kit-adl/astropix/3D/AstroPix1/deckel.PNG

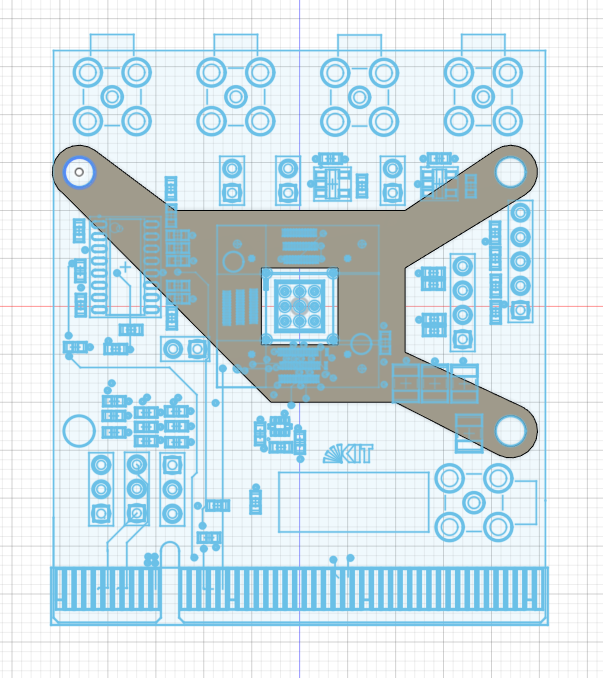
3D/AstroPix1/deckel.PNG
