kit-adl/astropix/README.md

# Astropix Repository

See PCB Folder for Altium designer project, and Astropix_v1_202004 for Astropix 1 Software and Nexys Video Firmware
