kit-adl/astropix/PCB/AstroPix4/pdf/4L_1.55mm_end_Cu 35 outer, 35 inner.pdf

A00 B00

50200238 | 18 | VS | 1
50200642 | 288 | | 2
50200643 | 0 | | 3

710

| 35 | L2
50200660 | | | 4
| 35 | L3
50200643 | 288 | | 5
50200642 | 0 | | 6
50200238 | 18 | RS | 7
Artikel: | 470 | ML4

Kunde:

Erstellt: | Kracht, Enrico
Datum: | 17.04.2015

Prozesstechnik: B: Undefiniert
Materialtext | Mat. Nr. | µm | Aufbau | Prozessaufbau
B00: | 1440 µm | Tol+: | 155 µm | Tol-: | 155 µm | Dmax: | 1595 µm | Dmin: | 1285 µm
0 µm | Tol+: | 0 µm | Tol-: | 0 µm | Dmax: | 0 µm | Dmin: | 0 µm
Dicke (D): | 1550 µm | Tol+: | 155 µm | Tol-: | 155 µm | Dmax: | 1705 µm | Dmin: | 1395 µm
Messstelle: (05) über LM und galv.Cu; beidseitig | nominal: | 1392 µm
