kit-adl/astropix/3D/AstroPix1/Deckel.stl

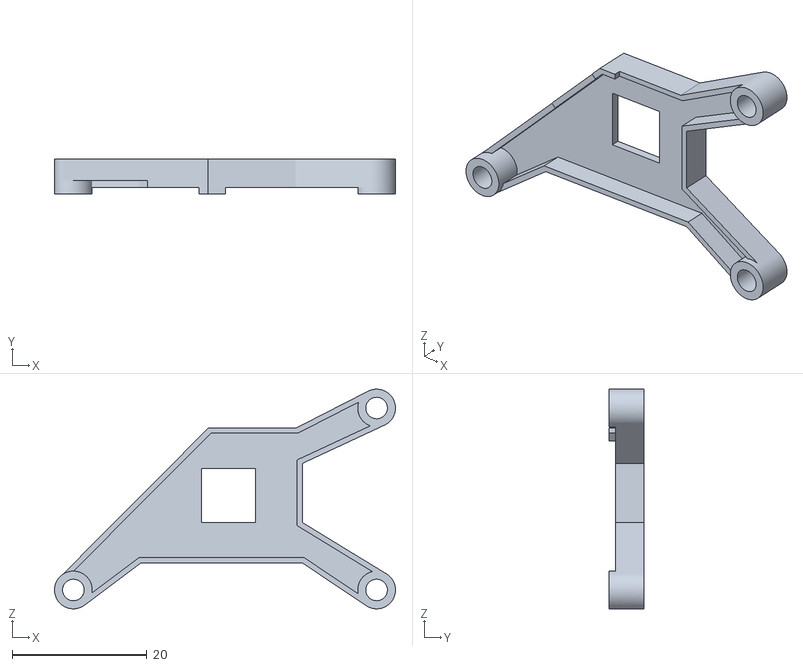
[picture p2: CAD file, 2021-02-23]
3D/AstroPix1/Deckel.stl
50.6 x 5.20 x 32.6
