kit-adl/astropix/3D/AstroPix2/astropix_v2.stl

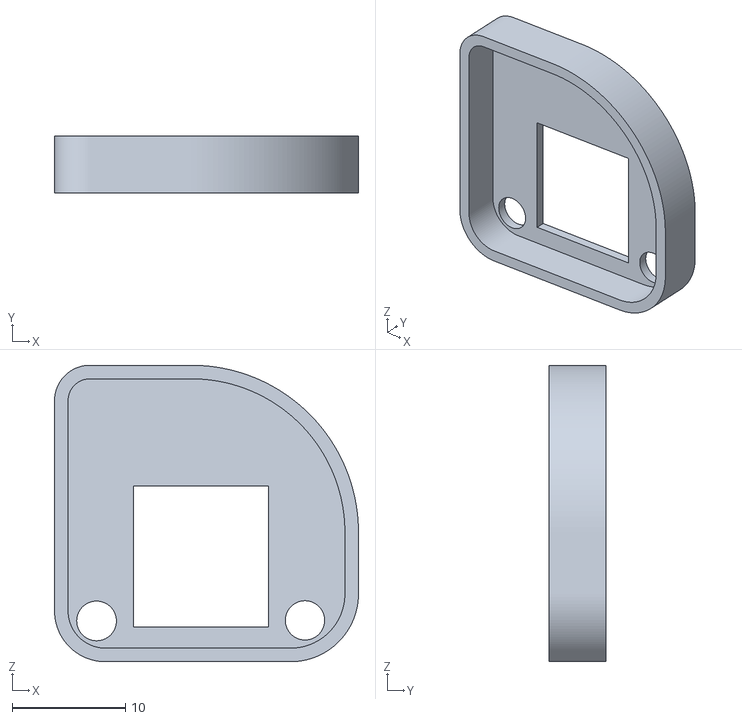
[picture p3: CAD file, 2021-11-17]
3D/AstroPix2/astropix_v2.stl
26.9 x 5.00 x 26.2
