kit-adl/astropix/PCB/AstroPix1/User Library-1x3 TH Pitch 2_54mm.SLDPRT

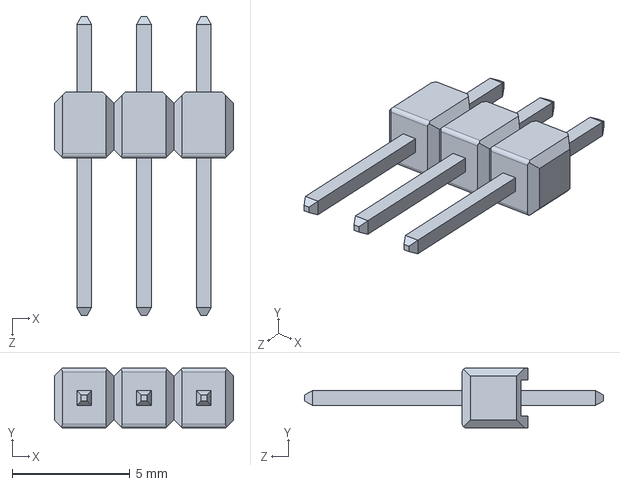
[picture p4: CAD file, 2020-10-21]
PCB/AstroPix1/User Library-1x3 TH Pitch 2_54mm.SLDPRT
7.62 x 2.54 x 12.7 mm
