kit-adl/astropix/PCB/AstroPix1/CircuitWorks-JUMPER.SLDPRT

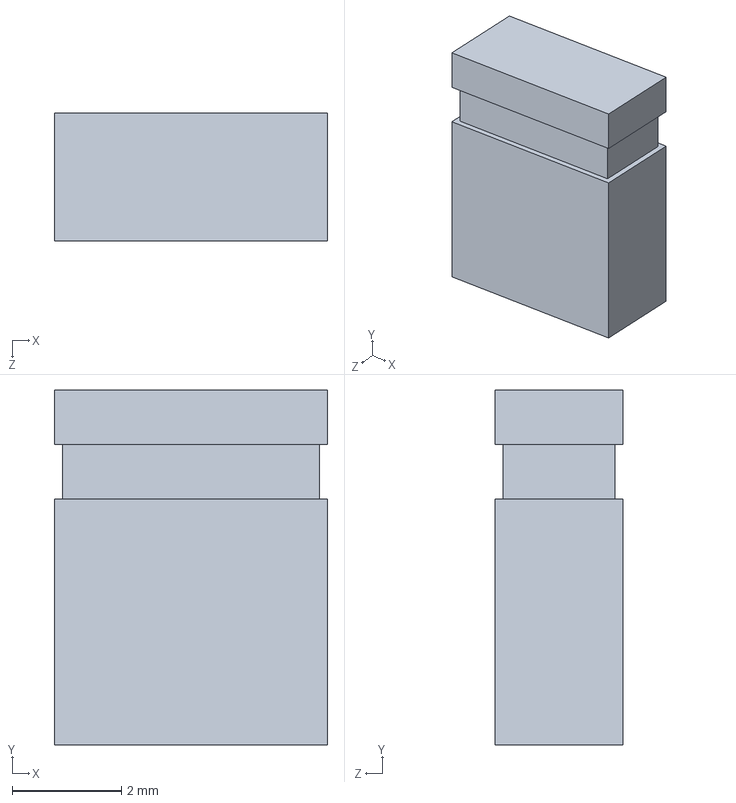
[picture p5: CAD file, 2020-10-21]
PCB/AstroPix1/CircuitWorks-JUMPER.SLDPRT
5.00 x 6.50 x 2.35 mm
