kit-adl/astropix/PCB/AstroPix1/User Library-HDR1X1 Rectangular Straight.SLDPRT

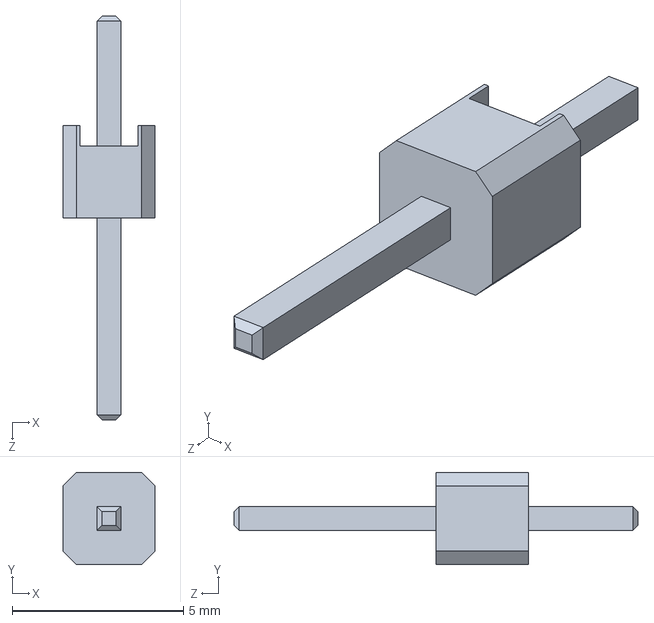
[picture p6: CAD file, 2020-10-21]
PCB/AstroPix1/User Library-HDR1X1 Rectangular Straight.SLDPRT
2.70 x 2.70 x 11.8 mm
