kit-adl/astropix/PCB/AstroPix1/Astropix_Carrier.pdf

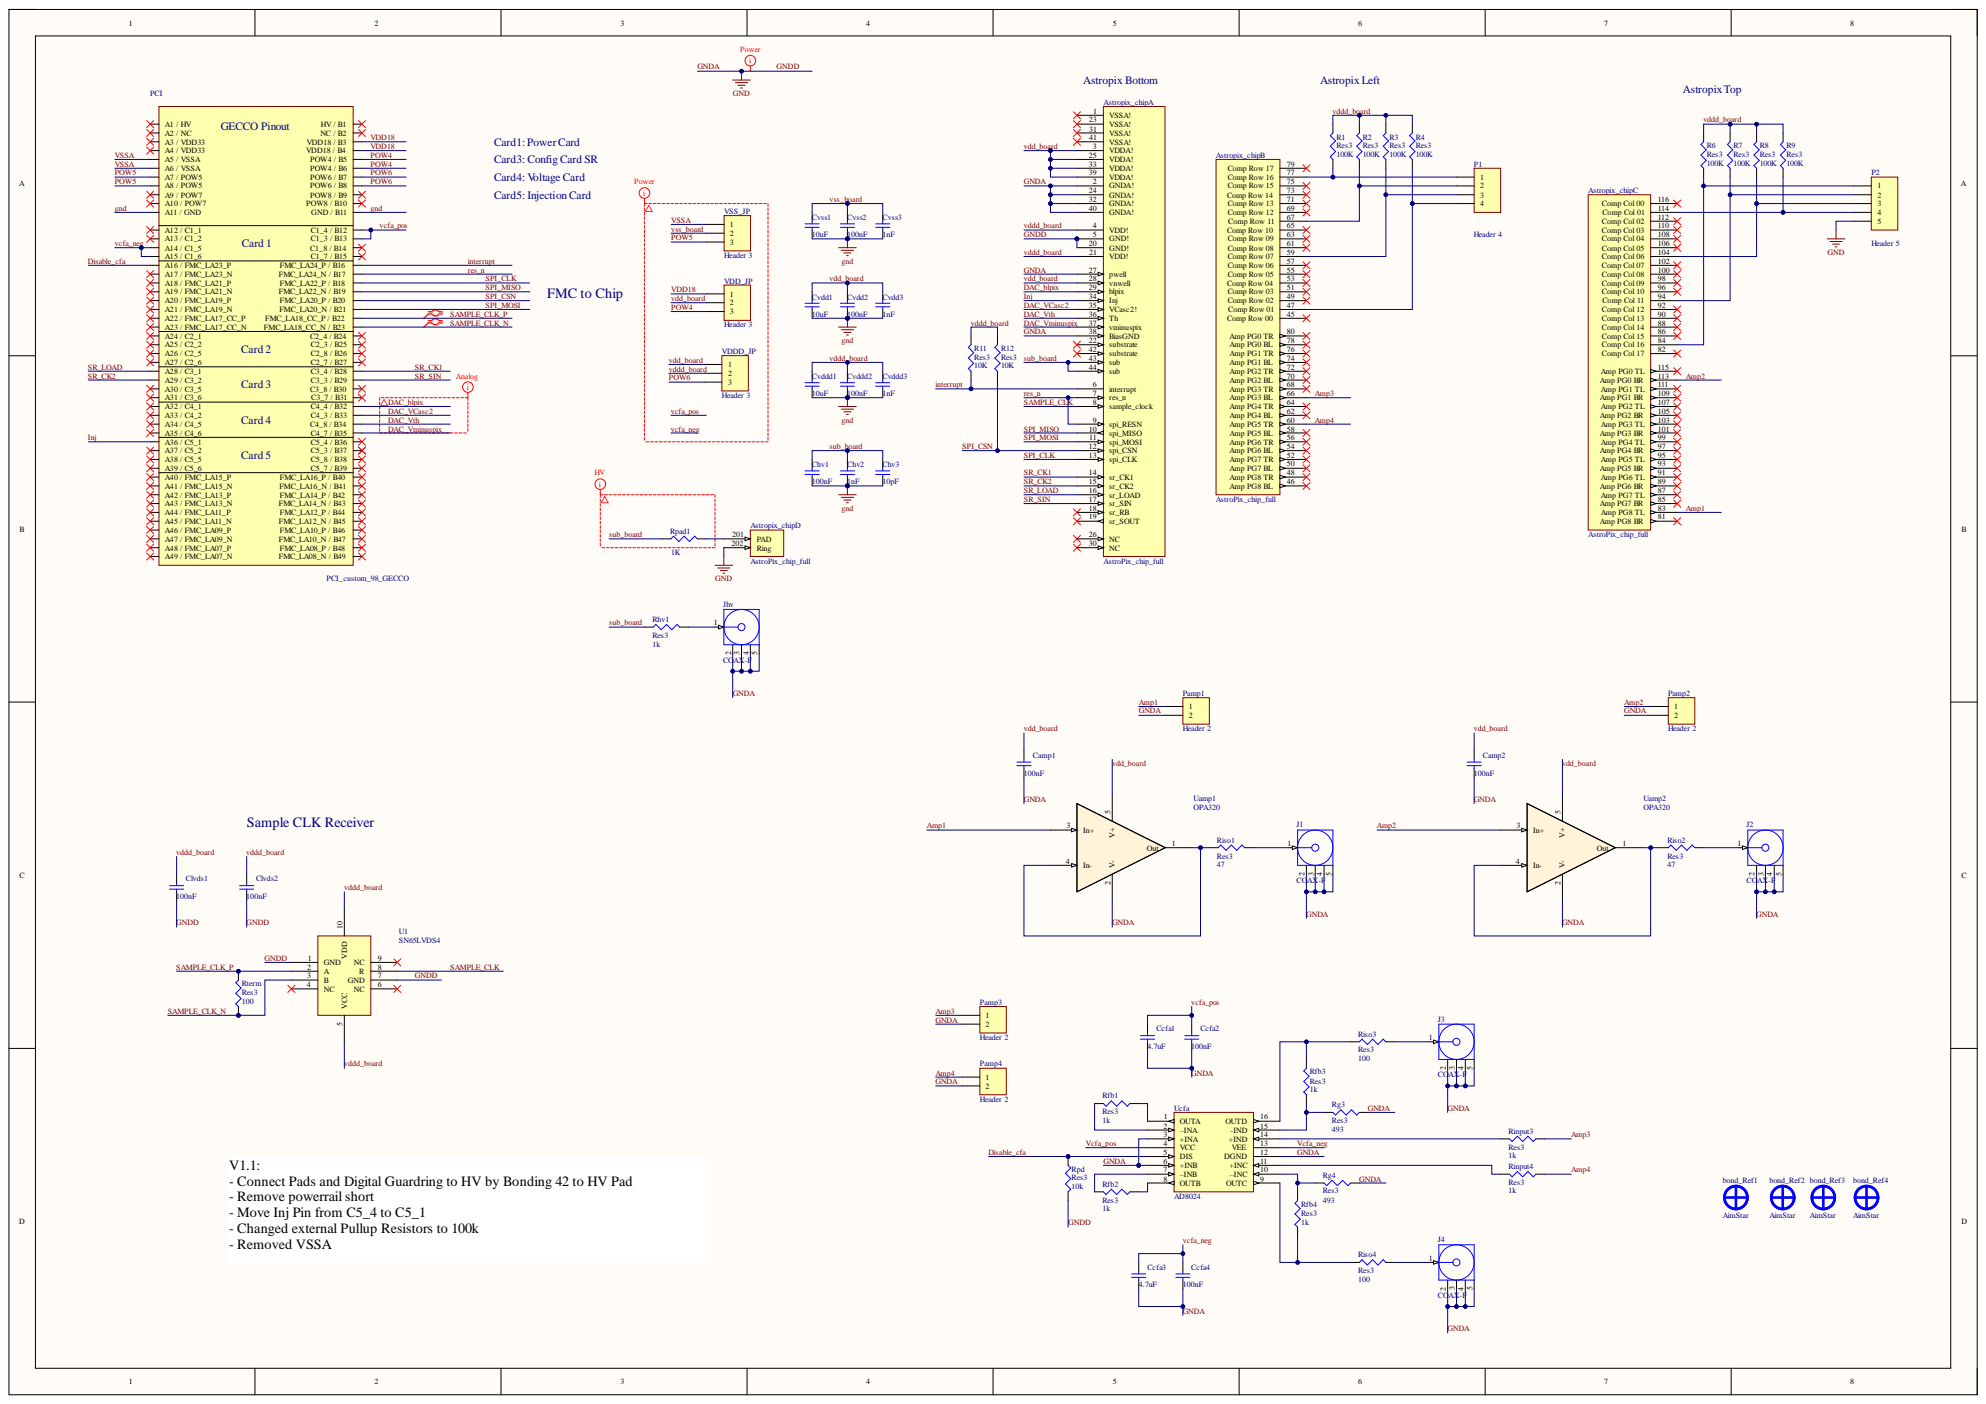
[picture p7: page 1]

- Connect Pads and Digital Guardring to HV by Bonding 42 to HV Pad
- Remove powerrail short
- Move Inj Pin from C5_4 to C5_1
- Changed external Pullup Resistors to 100k
- Removed VSSA

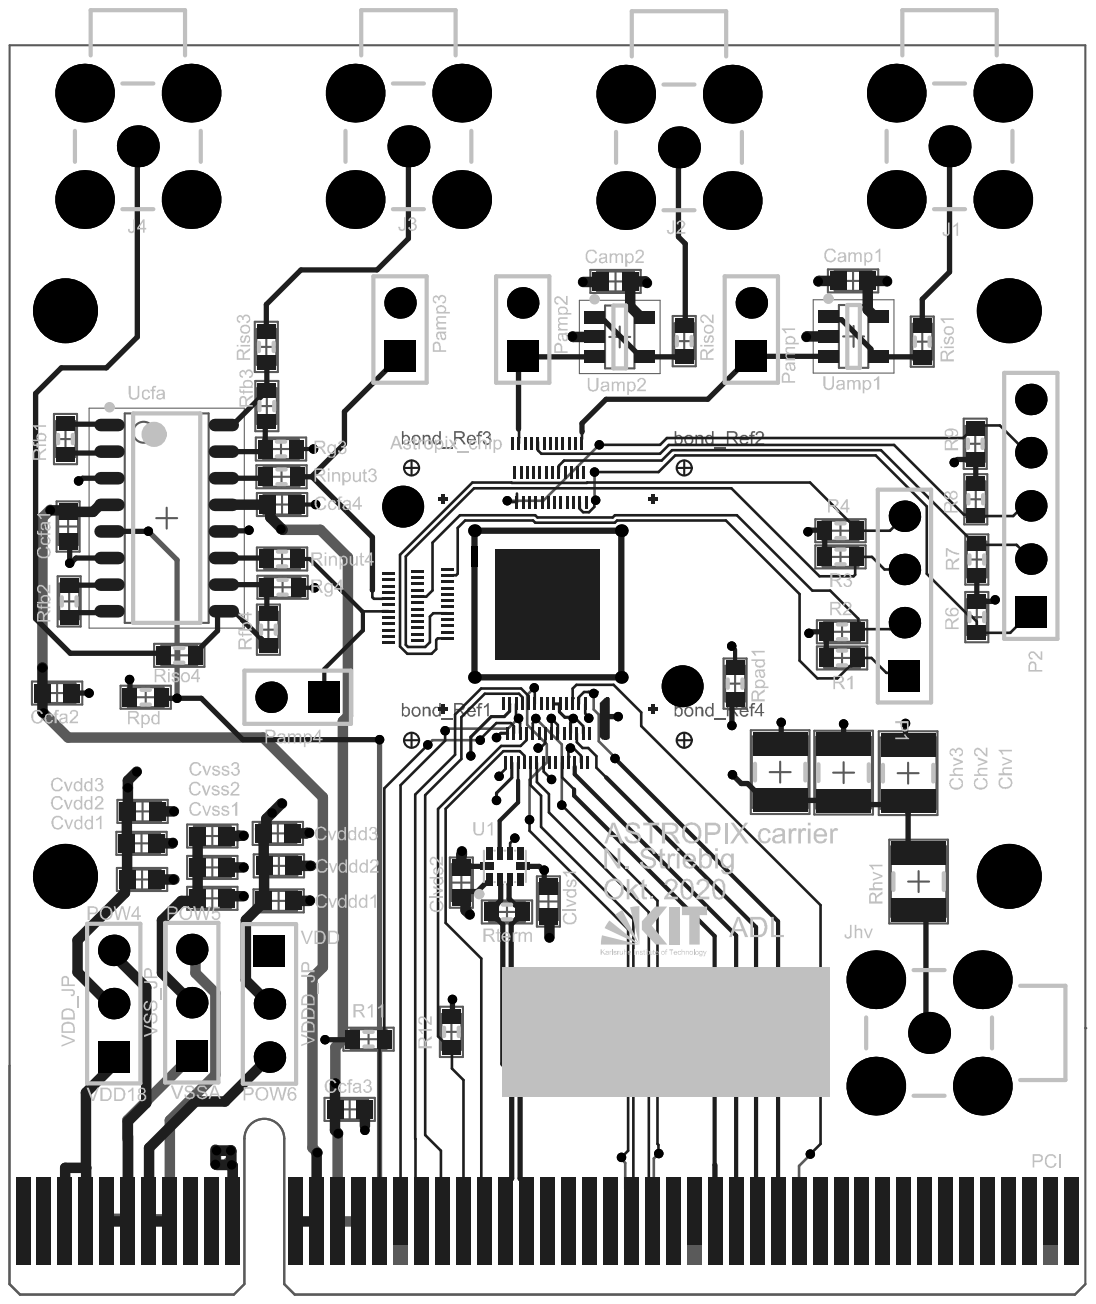
[picture p8: page 2]
