kit-adl/astropix/PCB/AstroPix2/pdf/astropix_v2.pdf

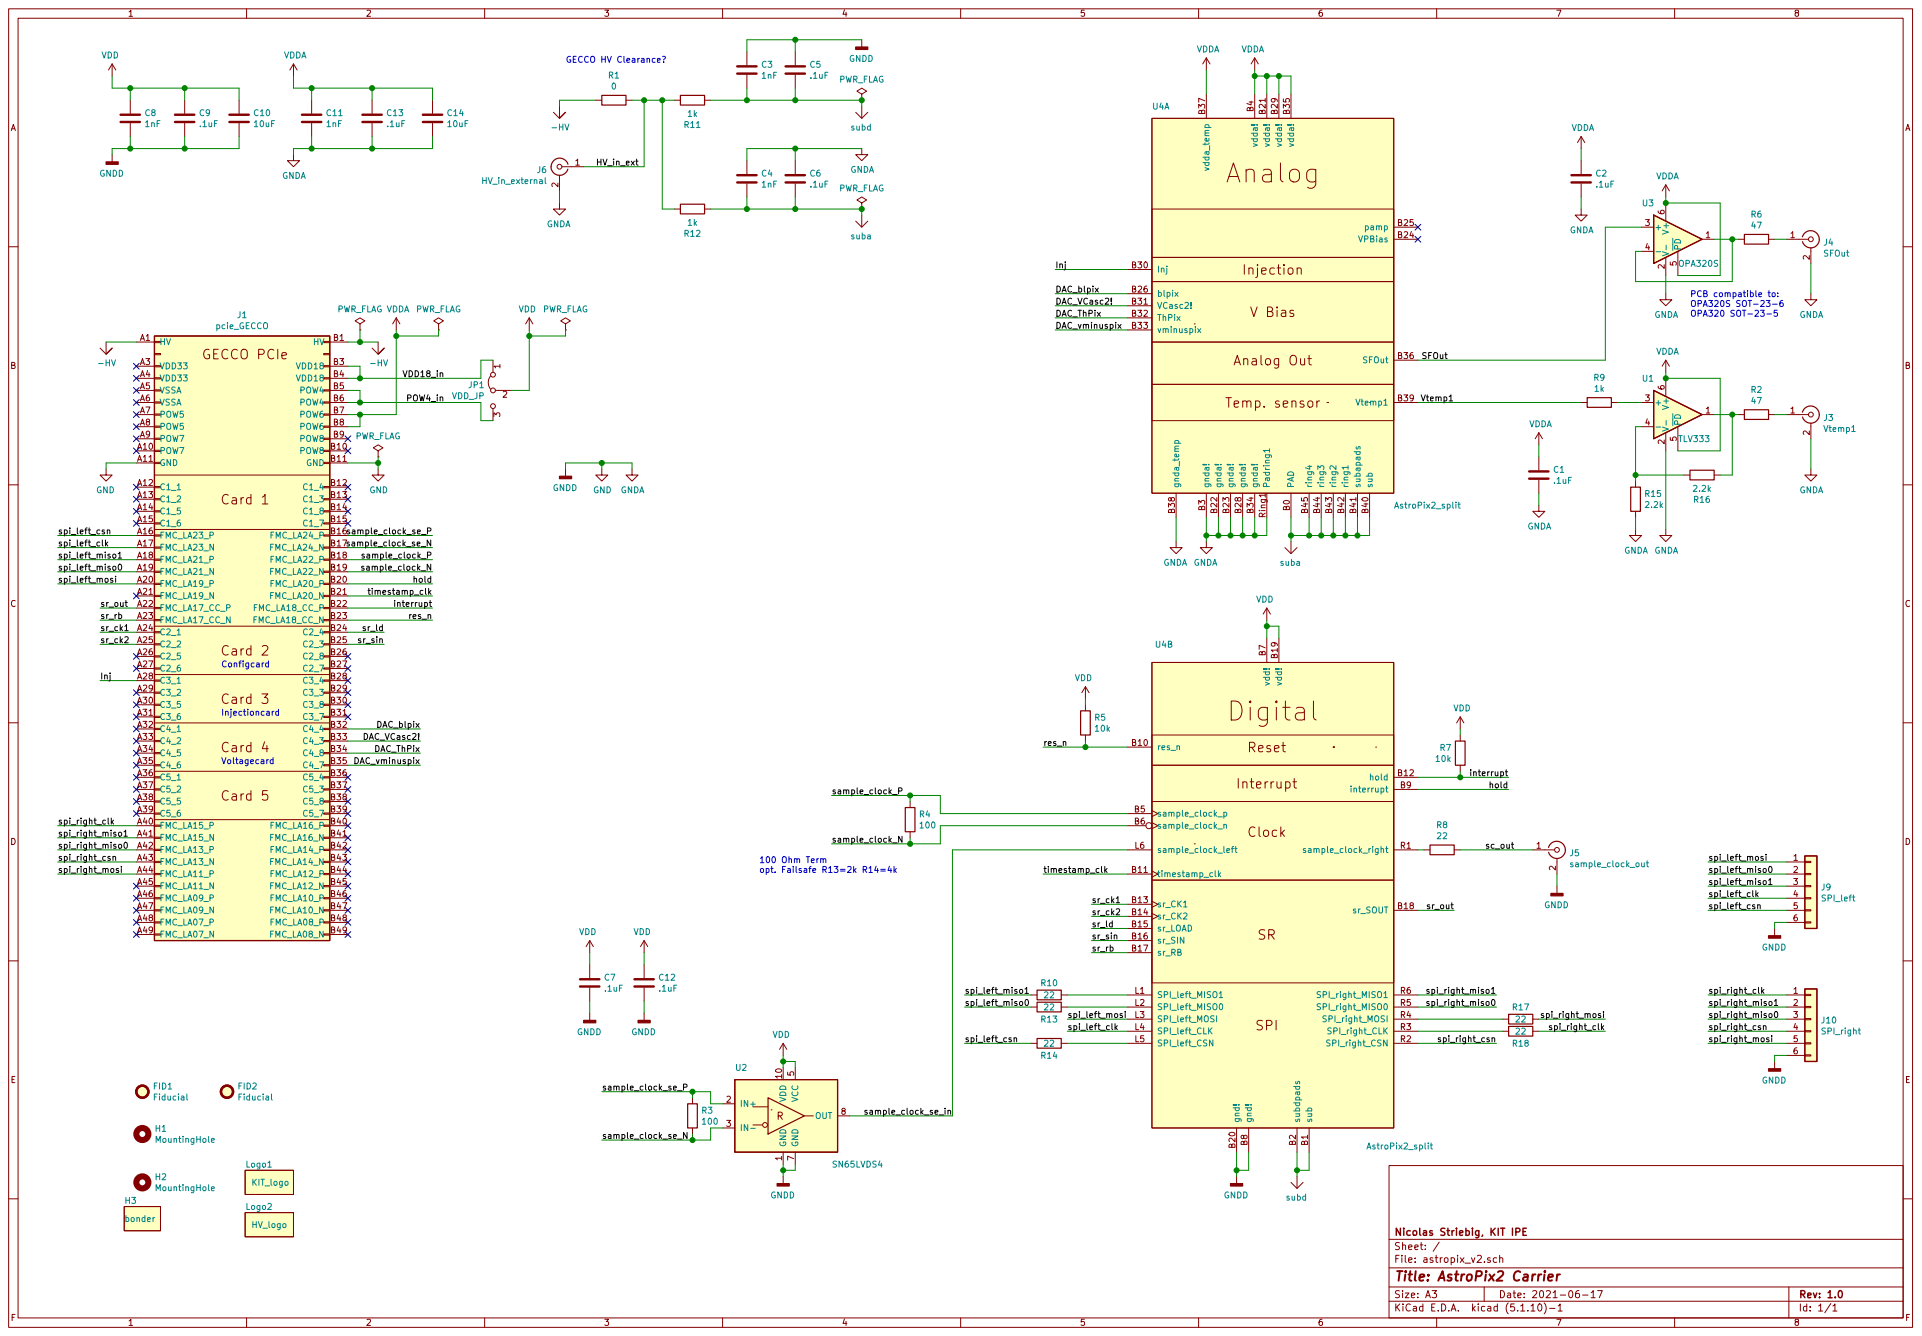
[picture p9: page 1]

PCB compatible to: OPA320S SOT-23-6 OPA320 SOT-23-5

VDD33 A4 FMC_LA15_P A40 FMC_LA15_N A41 FMC_LA13_P A42 FMC_LA13_N A43 FMC_LA11_P A44 FMC_LA11_N A45 FMC_LA09_P A46 FMC_LA09_N A47 FMC_LA07_P A48 FMC_LA07_N A49

Card 2

Card 3 Injectioncard

Card 4 Voltagecard

Card 5

File: astropix_v2.sch Sheet: / Nicolas Striebig, KIT IPE
