kit-adl/astropix/PCB/AstroPix4/assembly/astropix4_assembly_drawings.pdf

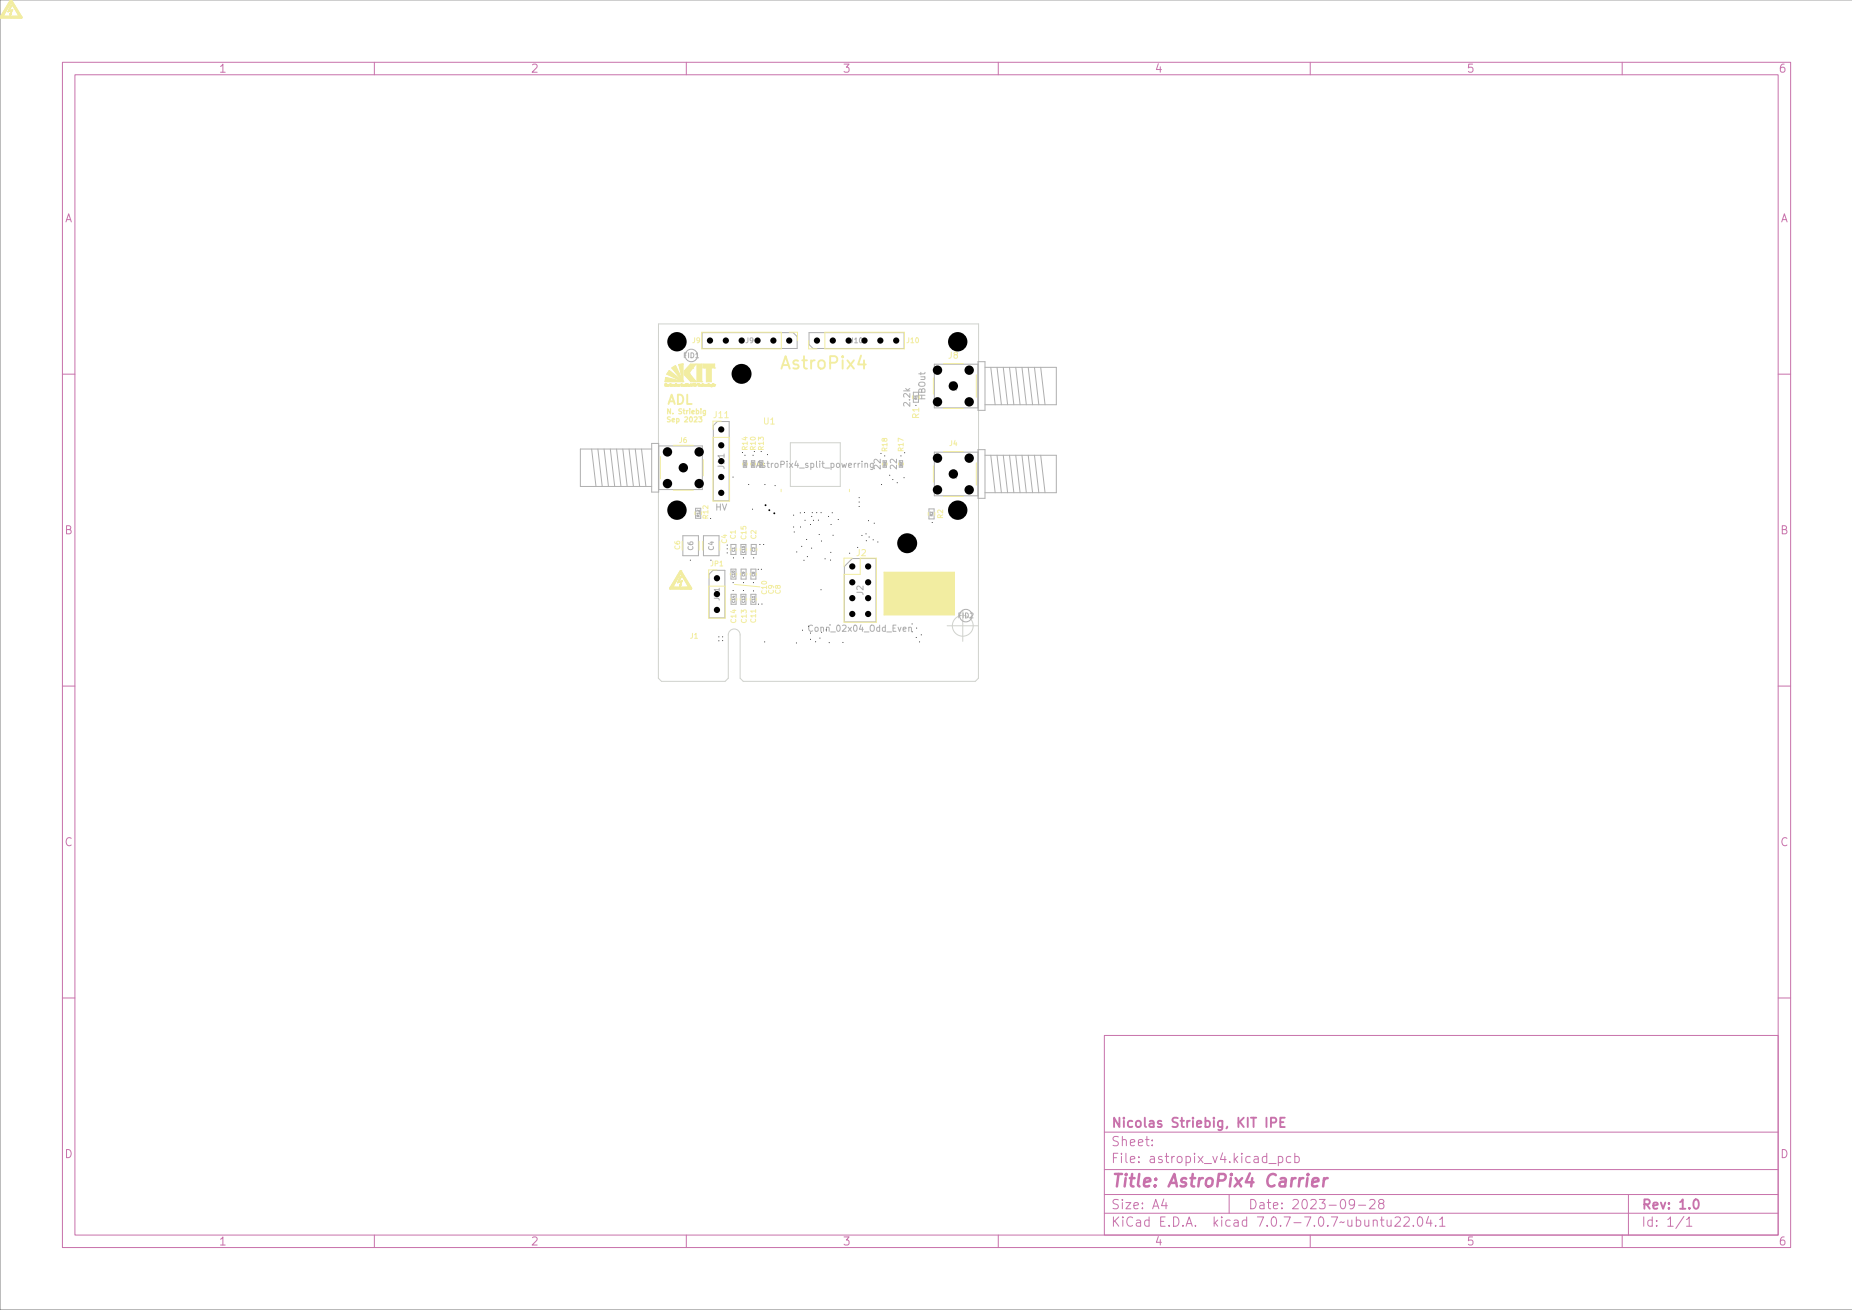
[picture p10: page 1]
