kit-adl/astropix/PCB/AstroPix4/assembly/astropix4_bondplan.pdf

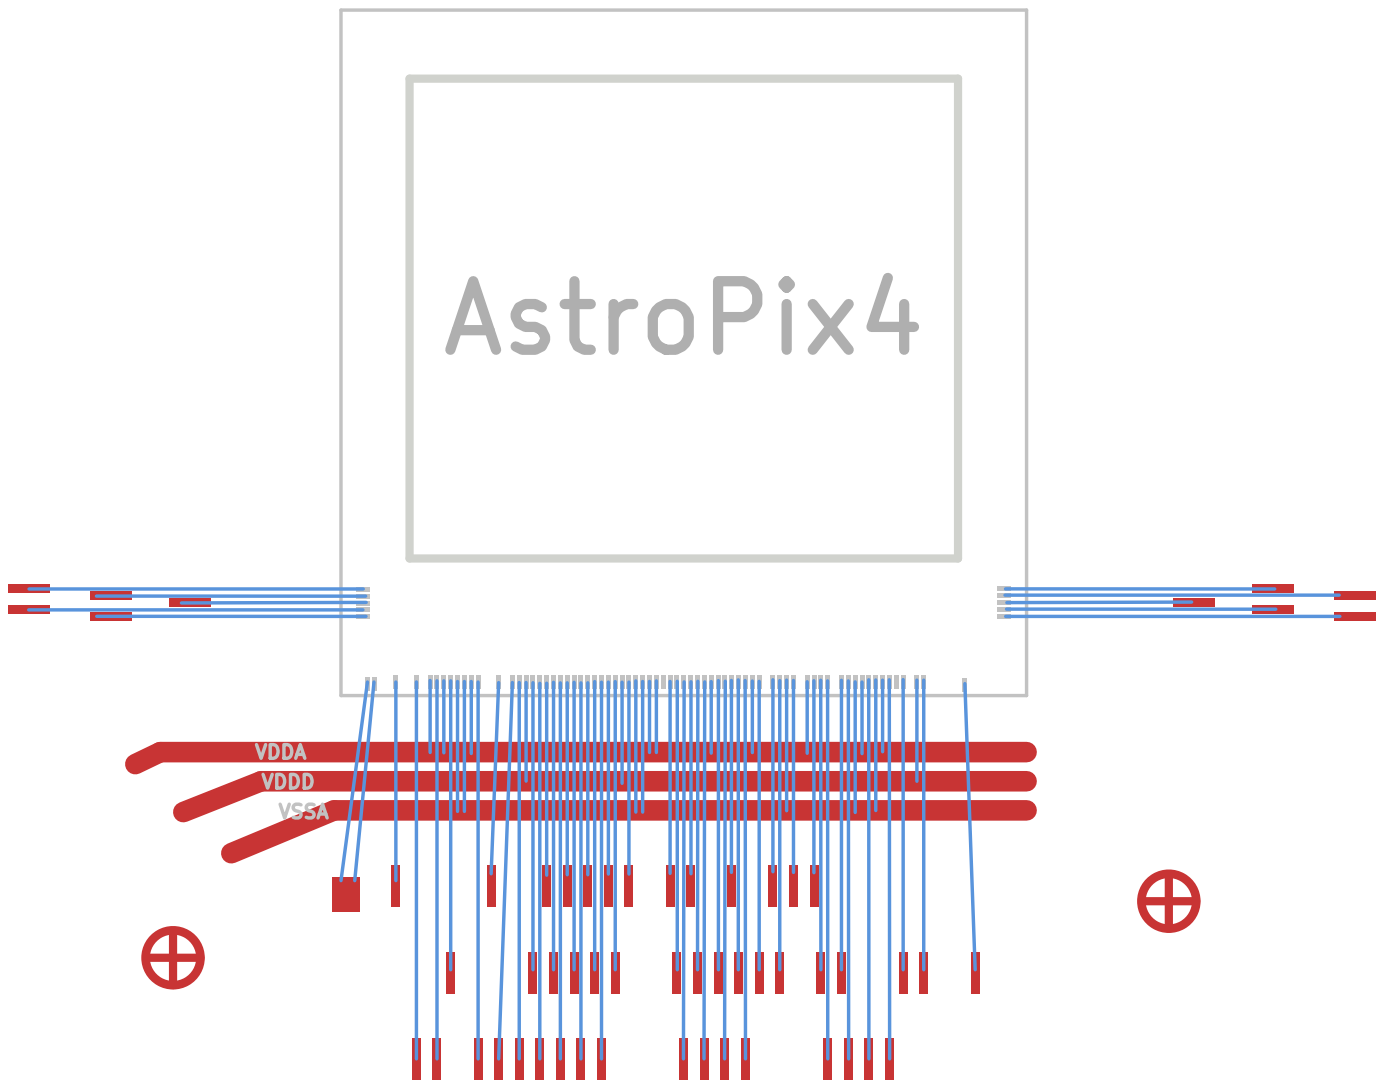
[picture p11: page 1]
