kit-adl/astropix/PCB/AstroPix2/assembly/drawings.pdf

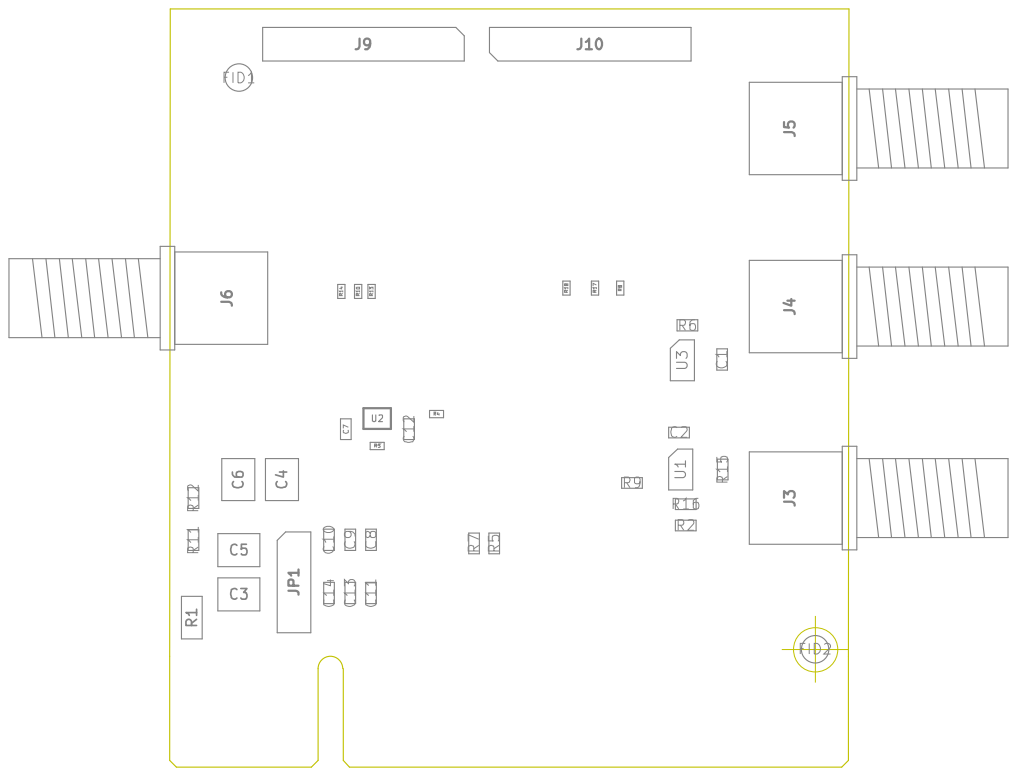
[picture p12: page 1]
