kit-adl/astropix/PCB/AstroPix1/PCI_ASTROPIX_carrier_Bondplan3.pdf

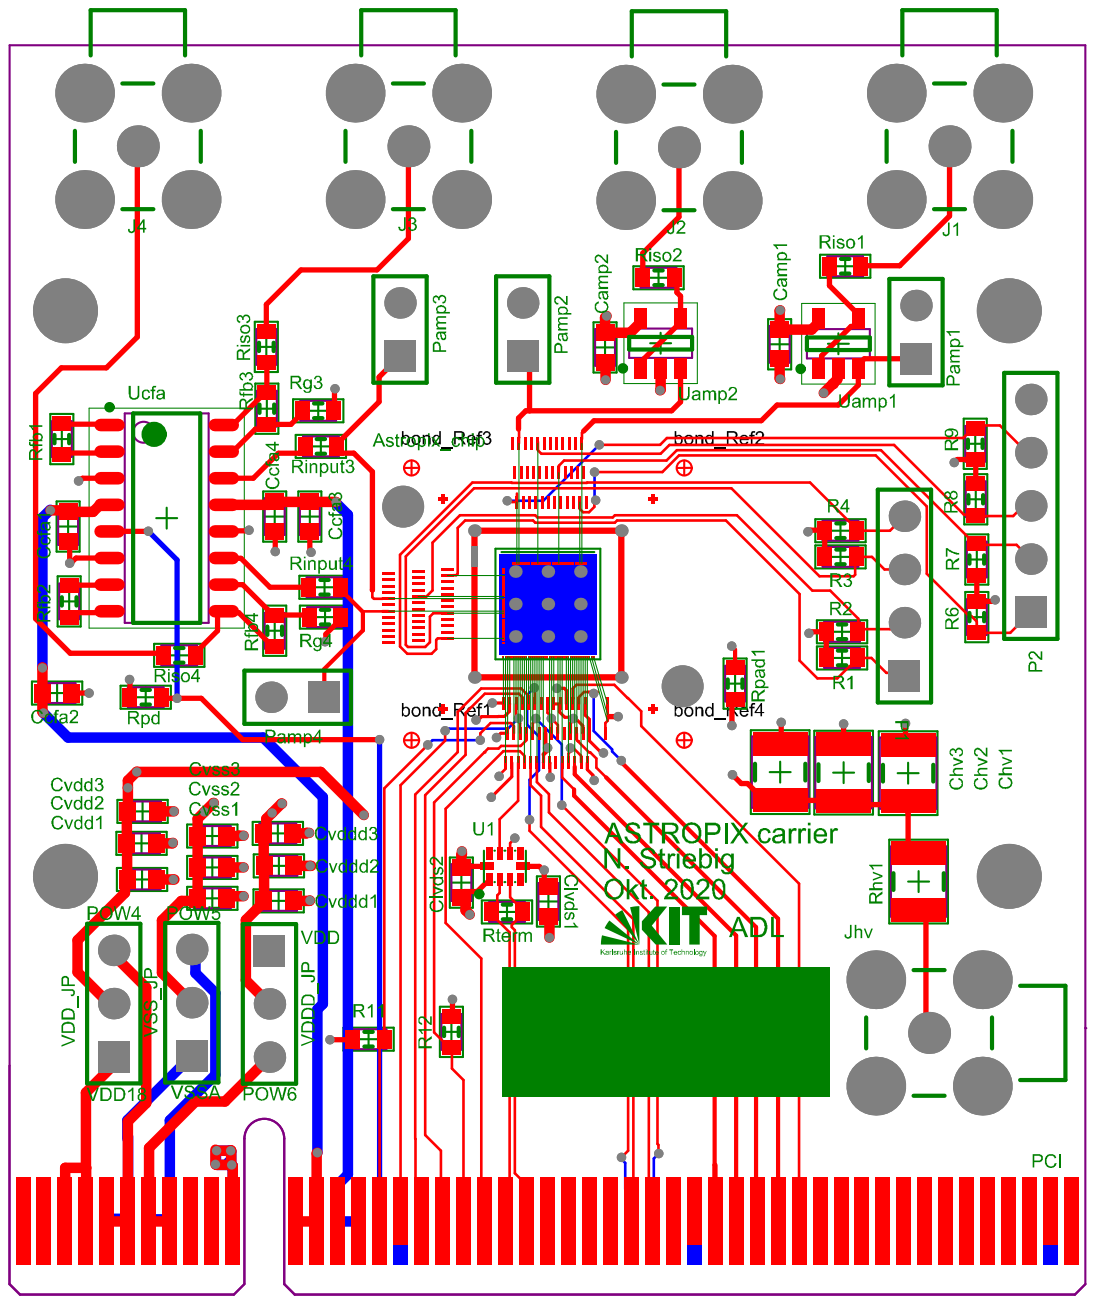
[picture p13: page 1]
