kit-adl/astropix/PCB/AstroPix4/pdf/astropix_v4.pdf

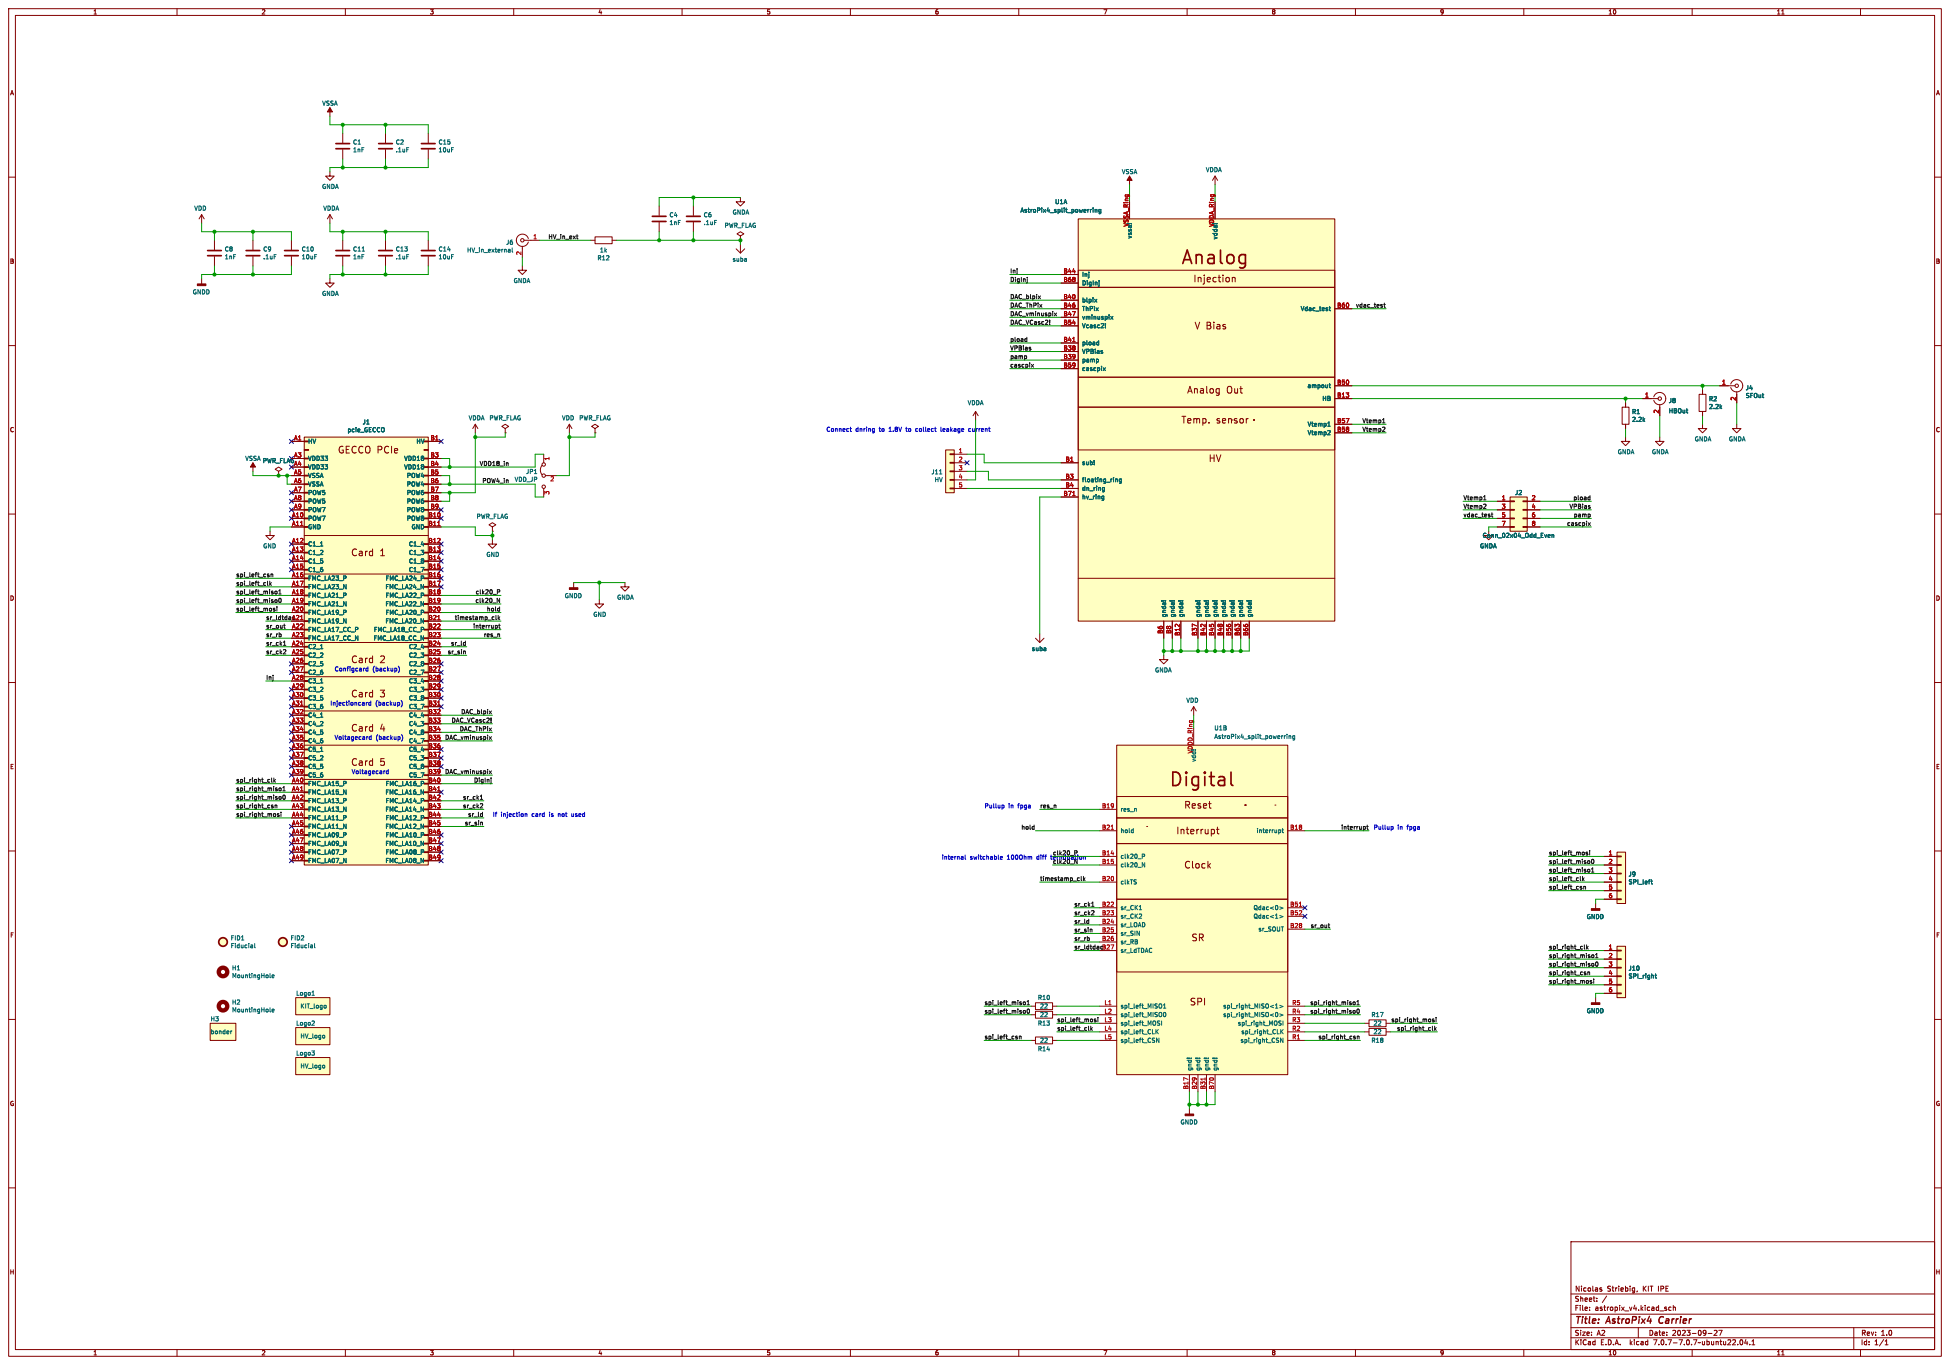
[picture p14: page 1]

res_n B19

hold B21
