kit-adl/astropix/PCB/AstroPix2/pdf/Astropix2_bondplan.pdf

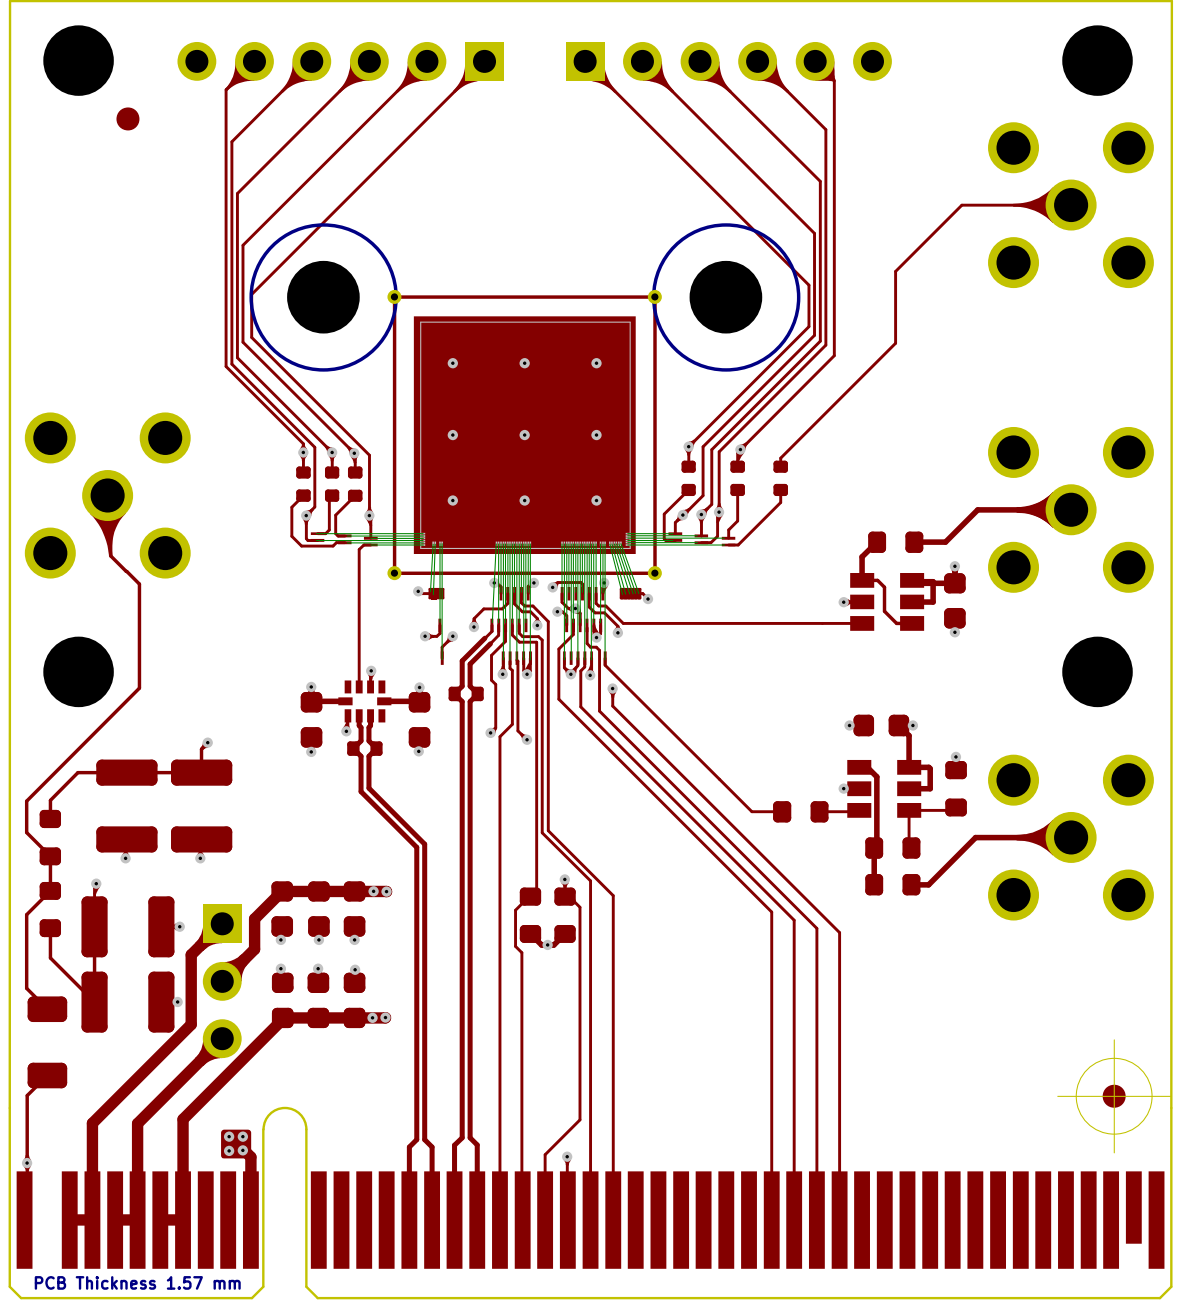
[picture p15: page 1]
