kit-adl/astropix/(list of files, drawings)

Other design files:
PCB/AstroPix1/Altium/PCI_express/PCI_custom_98.SchLib
PCB/AstroPix1/AstroPix.PcbLib
PCB/AstroPix1/AstroPix.SchLib
PCB/AstroPix1/Astropix_Carrier.PrjPcb
PCB/AstroPix1/Opamp.PcbLib
PCB/AstroPix1/Opamp.SchLib
PCB/AstroPix1/PCI_ASTROPIX_carrier.PcbDoc
PCB/AstroPix1/PCI_ASTROPIX_carrier.SchDoc
PCB/AstroPix1/PCI_ASTROPIX_carrier_Bondplan2.PcbDoc
PCB/AstroPix1/PCI_ASTROPIX_carrier_Bondplan.PcbDoc
PCB/AstroPix1/SN65LVDS4.PcbLib
PCB/AstroPix1/SN65LVDS4.SchLib
