kit-adl/astropix/FW/AstroPix2_telescope/GECCO_Firmware.src/spi_readout.v

/*
 * ATLASPix3_SoftAndFirmware
 * Copyright (C) 2019  Rudolf Schimassek (rudolf.schimassek@kit.edu)
 *
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
 * You should have received a copy of the GNU General Public License
 * along with this program.  If not, see <http://www.gnu.org/licenses/>.
 */
`timescale 1ns / 1ps
//////////////////////////////////////////////////////////////////////////////////
// Company:     KIT-ADL
// Engineer:    Rudolf Schimassek
//              Modified by: Nicolas Striebig
//
// Create Date: 24.07.2021
// Design Name:
// Module Name: SPI Readout for AstroPix 2
// Project Name:
// Target Devices:
// Tool Versions:
// Description: 5-Wire SPI Controller
//              Uses async FIFOs (ftdi_top/rfg/spi_xxx_fifo) to pass Write and Read data from lowspeed SPI clock to high-speed FTDI domain.
//              The readout Software accesses the data by writing/reading from/to the FTDI Registers 0x23/0x24.
//              Modes:
//                   WR: Write 32 Bit to MOSI and for every bit, read two bits from MISO
//                   R-only: Read two bits from MISO for 32 SPI clock cycles
// Dependencies:
//
// Revision:
// Revision 0.02 - File Created
//
// Additional Comments:
//
// TODOS:
// - Drive SPI_CS as GPIO via Software?
// - Write/Read on leading/trailing edge
//
//////////////////////////////////////////////////////////////////////////////////

module spi_readout#(
    parameter CPOL = 0,
    parameter CPHA = 1)
(
    input  wire         clock,
    input  wire         reset,
    input  wire [7:0]   clock_divider,

    output reg          spi_csb,
    output wire         spi_clock,
    output reg          spi_mosi,
    input  wire         spi_miso0,
    input  wire         spi_miso1,

    input  wire         readback_en,
    input  wire [31:0]  data_in_fifo_data,
    input  wire         data_in_fifo_empty,
    output wire         data_in_fifo_clock,
    output reg          data_in_fifo_rd_en,

    output reg  [63:0]  data_out_fifo_data,
    input  wire         data_out_fifo_full,
    output wire         data_out_fifo_clock,
    output reg          data_out_fifo_wr_en,

    output reg          trigger
);


reg [6:0] clock_div_counter = 0;

reg [31:0] shift_data_in = 0;

reg [2:0] state = 0;
reg [6:0] loop_counter = 0;
reg temp_clk;

reg clk_en;

localparam idle         = 3'b000;
localparam load_data    = 3'b001;
localparam read_data    = 3'b010;
localparam write_data   = 3'b011;
localparam ending       = 3'b100;

assign data_in_fifo_clock = temp_clk;
assign data_out_fifo_clock = temp_clk;

//Assign Clock with correct phase and only when writing
assign spi_clock = (clk_en) && (CPHA ? ~temp_clk : temp_clk);

always @(posedge clock) begin
    if(reset) begin
        spi_csb <= 1;
        spi_mosi <= 0;

        temp_clk <= CPOL;

        data_in_fifo_rd_en <= 0;
        data_out_fifo_wr_en <= 0;

        data_out_fifo_data <= 64'b0;

        clock_div_counter <= 0;
        loop_counter <= 0;

        clk_en <= 0;

        trigger <= 0;

        state <= 0;
    end
    else begin
        //SPI Clock divider
        if(clock_div_counter[6:0] < clock_divider[7:1])
            clock_div_counter <= clock_div_counter + 8'b1;
        else begin
            clock_div_counter <= 0;

            temp_clk  <= ~temp_clk;

            if(temp_clk == 1) begin
                case(state)
                    idle: begin

                        //Disable ReadFIFO
                        data_out_fifo_wr_en <= 0;

                        loop_counter <= 0;

                        //~data_in_fifo_empty is 1 if words in in_fifo < 4
                        if(~data_in_fifo_empty)
                            state <= load_data;
                    end

                    load_data: begin //Load data mode
                        clk_en <= 0;

                        //don't load data in read-only mode
                        if(readback_en) begin
                                if(shift_data_in[16] == 1)
                                    trigger <= 1;
                                state <= read_data;
                                loop_counter <= 32;
                        end else begin
                            shift_data_in <= {shift_data_in[23:0], data_in_fifo_data[7:0]};

                            data_in_fifo_rd_en <= 1;

                            //load data to write in 4 clock cycles
                            if(loop_counter >= 3) begin

                                //Assign Chip-select one cycle before SPI clock starts
                                spi_csb <= 0;

                                state <= write_data;
                                loop_counter <= 32;

                            end
                            else
                                loop_counter <= loop_counter + 7'b1;
                        end
                    end

                    read_data: begin //Readonly mode
                        clk_en <= 1;
                        data_in_fifo_rd_en <= 0;
                        loop_counter <= loop_counter + 7'b1;

                        //Read 2 MISO bits
                        data_out_fifo_data <= data_out_fifo_data[63:0] << 2 | spi_miso0 << 1 | spi_miso1;

                        if(loop_counter >= 63)
                            state <= ending;
                    end

                    write_data: begin //RW mode

                        //Enable Clock
                        clk_en <= 1;

                        //Disable WriteFIFO
                        data_in_fifo_rd_en <= 0;

                        loop_counter <= loop_counter + 7'b1;

                        //Read 2 MISO bits
                        data_out_fifo_data <= data_out_fifo_data[63:0] << 2 | spi_miso0 << 1 | spi_miso1;

                        //Shift-out MOSI
                        spi_mosi <= shift_data_in[31];
                        shift_data_in <= {shift_data_in[30:0],1'b0};

                        //Go to end state after writing/reading 32 bits
                        if(loop_counter >= 63) begin
                                state <= ending;
                        end
                    end

                    ending: begin
                        //Always write MISO stream to ReadFIFO
                        //data_out_fifo_wr_en <= 1;

                        //Disable spi_clock
                        clk_en <= 0;

                        //Deassert chip-select
                        spi_csb <= 1;

                        trigger <= 0;

                        if(~data_out_fifo_full) begin //wait for space in the FIFO
                            data_out_fifo_wr_en <= 1;
                            state <= idle;
                        end

                        state <= idle;
                    end
                endcase
            end
        end
    end
end

endmodule
