kit-adl/astropix/FW/AstroPix2_telescope/GECCO_Firmware.src/ip/selectio_wiz_0/selectio_wiz_0_selectio_wiz.v

// file: selectio_wiz_0_selectio_wiz.v
// (c) Copyright 2009 - 2013 Xilinx, Inc. All rights reserved.
// 
// This file contains confidential and proprietary information
// of Xilinx, Inc. and is protected under U.S. and
// international copyright and other intellectual property
// laws.
// 
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
// CRITICAL APPLICATIONS
// Xilinx products are not designed or intended to be fail-
// safe, or for use in any application requiring fail-safe
// performance, such as life-support or safety devices or
// systems, Class III medical devices, nuclear facilities,
// applications related to the deployment of airbags, or any
// other applications that could lead to death, personal
// injury, or severe property or environmental damage
// (individually and collectively, "Critical
// Applications"). Customer assumes the sole risk and
// liability of any use of Xilinx products in Critical
// Applications, subject only to applicable laws and
// regulations governing limitations on product liability.
// 
// THIS COPYRIGHT NOTICE AND DISCLAIMER MUST BE RETAINED AS
// PART OF THIS FILE AT ALL TIMES.
//----------------------------------------------------------------------------
// User entered comments
//----------------------------------------------------------------------------
// None
//----------------------------------------------------------------------------

`timescale 1ps/1ps

module selectio_wiz_0_selectio_wiz
   // width of the data for the system
 #(parameter SYS_W = 1,
   // width of the data for the device
   parameter DEV_W = 6)
 (
  // From the system into the device
  input  [SYS_W-1:0] data_in_from_pins_p,
  input  [SYS_W-1:0] data_in_from_pins_n,
  output [DEV_W-1:0] data_in_to_device,
  input  [SYS_W-1:0]             bitslip,       // Bitslip module is enabled in NETWORKING mode
                                    // User should tie it to '0' if not needed
  input              clk_in,        // Fast clock input from PLL/MMCM
  input              clk_div_in,    // Slow clock input from PLL/MMCM
  input              io_reset);
  localparam         num_serial_bits = DEV_W/SYS_W;
  wire clock_enable = 1'b1;
  // Signal declarations
  ////------------------------------
  // After the buffer
  wire   [SYS_W-1:0] data_in_from_pins_int;
  // Between the delay and serdes
  wire [SYS_W-1:0]  data_in_from_pins_delay;
  // Array to use intermediately from the serdes to the internal
  //  devices. bus "0" is the leftmost bus
  wire [SYS_W-1:0]  iserdes_q[0:13];   // fills in starting with 0
  // Create the clock logic


  // We have multiple bits- step over every bit, instantiating the required elements
  genvar pin_count;
  genvar slice_count;
  generate for (pin_count = 0; pin_count < SYS_W; pin_count = pin_count + 1) begin: pins
    // Instantiate the buffers
    ////------------------------------
    // Instantiate a buffer for every bit of the data bus
    IBUFDS
      #(.DIFF_TERM  ("FALSE"),             // Differential termination
        .IOSTANDARD ("LVDS_25"))
     ibufds_inst
       (.I          (data_in_from_pins_p  [pin_count]),
        .IB         (data_in_from_pins_n  [pin_count]),
        .O          (data_in_from_pins_int[pin_count]));

    // Pass through the delay
    ////-------------------------------
   assign data_in_from_pins_delay[pin_count] = data_in_from_pins_int[pin_count];
 
     // Instantiate the serdes primitive
     ////------------------------------

     // local wire only for use in this generate loop
     wire cascade_shift;
     wire [SYS_W-1:0] icascade1;
     wire [SYS_W-1:0] icascade2;
     wire clk_in_int_inv;

     assign clk_in_int_inv = ~ clk_in;

     // declare the iserdes
     ISERDESE2
       # (
         .DATA_RATE         ("DDR"),
         .DATA_WIDTH        (6),
         .INTERFACE_TYPE    ("NETWORKING"), 
         .DYN_CLKDIV_INV_EN ("FALSE"),
         .DYN_CLK_INV_EN    ("FALSE"),
         .NUM_CE            (2),
         .OFB_USED          ("FALSE"),
         .IOBDELAY          ("NONE"),                               // Use input at D to output the data on Q
         .SERDES_MODE       ("MASTER"))
       iserdese2_master (
         .Q1                (iserdes_q[0][pin_count]),
         .Q2                (iserdes_q[1][pin_count]),
         .Q3                (iserdes_q[2][pin_count]),
         .Q4                (iserdes_q[3][pin_count]),
         .Q5                (iserdes_q[4][pin_count]),
         .Q6                (iserdes_q[5][pin_count]),
         .Q7                (iserdes_q[6][pin_count]),
         .Q8                (iserdes_q[7][pin_count]),
         .SHIFTOUT1         (),
         .SHIFTOUT2         (),
         .BITSLIP           (bitslip[pin_count]),                             // 1-bit Invoke Bitslip. This can be used with any DATA_WIDTH, cascaded or not.
                                                                   // The amount of BITSLIP is fixed by the DATA_WIDTH selection.
         .CE1               (clock_enable),                        // 1-bit Clock enable input
         .CE2               (clock_enable),                        // 1-bit Clock enable input
         .CLK               (clk_in),                              // Fast clock driven by MMCM
         .CLKB              (clk_in_int_inv),                      // Locally inverted fast 
         .CLKDIV            (clk_div_in),                          // Slow clock from MMCM
         .CLKDIVP           (1'b0),
         .D                 (data_in_from_pins_delay[pin_count]),  // 1-bit Input signal from IOB 
         .DDLY              (1'b0),                                // 1-bit Input from Input Delay component 
         .RST               (io_reset),                            // 1-bit Asynchronous reset only.
         .SHIFTIN1          (1'b0),
         .SHIFTIN2          (1'b0),
    // unused connections
         .DYNCLKDIVSEL      (1'b0),
         .DYNCLKSEL         (1'b0),
         .OFB               (1'b0),
         .OCLK              (1'b0),
         .OCLKB             (1'b0),
         .O                 ());                                   // unregistered output of ISERDESE1

     // Concatenate the serdes outputs together. Keep the timesliced
     //   bits together, and placing the earliest bits on the right
     //   ie, if data comes in 0, 1, 2, 3, 4, 5, 6, 7, ...
     //       the output will be 3210, 7654, ...
     ////---------------------------------------------------------
     for (slice_count = 0; slice_count < num_serial_bits; slice_count = slice_count + 1) begin: in_slices
        // This places the first data in time on the right
        assign data_in_to_device[slice_count] =
          iserdes_q[num_serial_bits-slice_count-1];
        // To place the first data in time on the left, use the
        //   following code, instead
        // assign data_in_to_device[slice_count] =
        //   iserdes_q[slice_count];
     end
  end
  endgenerate
  
//// NO ODELAY

endmodule
