kit-adl/astropix/FW/AstroPix2_telescope/GECCO_Firmware.srcs/spi_tb/new/spi.v

`timescale 1 ns/1 ps

module fifo_write #(
    parameter WIDTH=8,
              READ=0
)(
    input  wire      clk,
    input wire enable,
    input wire reset,
    output reg empty,
    input  wire[WIDTH-1:0] data_in,
    output reg [WIDTH-1:0] data_out
);

logic [7:0] mem [0:3] = '{ '{0,0,0,0,0,0,0,1},'{0,0,0,0,0,0,1,1},'{0,0,0,0,0,1,1,1},'{0,0,0,0,1,1,1,1}};
logic [1:0] i;

always @(posedge clk, posedge reset) begin
    if (reset) begin
        data_out <= 0;
        i <= 0;
        empty <= 0;
    end
    else begin
        if(enable && !empty) begin
            //data_out <= mem[i][7:0];
            i <= i + 2'd1;
            //if(i == 3)
            //    empty <= 1;
        end
        assign data_out = mem[i][7:0];
    end
end

endmodule

module fifo_read #(
    parameter WIDTH=32,
              READ=0
)(
    input  wire      clk,
    input wire enable,
    input wire reset,
    input  wire[WIDTH-1:0] data_in,
    output reg [WIDTH-1:0] data_out
);
logic [63:0] mem [7:0];
bit [2:0] ptr;

always @(posedge clk, posedge reset) begin
    if (reset) begin
        data_out <= 0;
        ptr <= 0;
    end
    else begin
        if(enable) begin
            mem[ptr] <= data_in;
            data_out <= data_in;
            ptr <= ptr + 1;
        end
    end
end

endmodule

module spi_readout_test_tb;

parameter CPOL = 0;
parameter CPHA = 1;
parameter CS_INACTIVE_CLKS = 2;

reg clk;

reg reset;
reg [7:0] clk_div;
reg [31:0] tx_data;

wire data_in_fifo_empty;

wire spi_csb;
reg spi_miso0;
reg spi_miso1;
wire spi_mosi;
wire spi_sck;

reg readback_en;


reg spi_write_fifo_empty;
wire spi_write_fifo_rd_clk;
wire spi_write_fifo_rd_en;

wire [31:0] spi_write_fifo_dout;
wire [63:0] spi_read_fifo_din;
reg spi_read_fifo_full;
wire spi_read_fifo_wr_clk;
wire spi_read_fifo_wr_en;

wire [63:0] spi_out;

reg interrupt;

fifo_write fifo_i(
    .clk(spi_write_fifo_rd_clk),
    .enable(spi_write_fifo_rd_en),
    .empty(data_in_fifo_empty),
    .reset(reset),
    .data_in(tx_data),
    .data_out(spi_write_fifo_dout)
);

fifo_read #(
    .WIDTH(64))
fifo_o(
    .clk(spi_read_fifo_wr_clk),
    .enable(spi_read_fifo_wr_en),
    .reset(reset),
    .data_in(spi_read_fifo_din),
    .data_out(spi_out)
);

//spi_readout2 #(
spi_readout_interrupt #(
    .CPOL(CPOL),
    .CPHA(CPHA))

spi_readout_i 
(
    .clock(clk),
    .reset(reset),
    .clock_divider(clk_div),
    
    .spi_csb(spi_csb),
    .spi_clock(spi_sck),
    .spi_mosi(spi_mosi),
    .spi_miso0(spi_miso0),
    .spi_miso1(spi_miso1),
    
    .readback_en(readback_en),
    .data_in_fifo_data(spi_write_fifo_dout),
    .data_in_fifo_clock(spi_write_fifo_rd_clk),
    .data_in_fifo_rd_en(spi_write_fifo_rd_en),
    .data_in_fifo_empty(data_in_fifo_empty),
    
    .data_out_fifo_data(spi_read_fifo_din),
    .data_out_fifo_clock(spi_read_fifo_wr_clk),
    .data_out_fifo_wr_en(spi_read_fifo_wr_en),
    .data_out_fifo_full(spi_read_fifo_full),
    
    .interruptB(interrupt),
    .interrupt_mode(1'b1)
);
initial
    $monitor("spi_out.%b",spi_out);
initial begin
reset = 0;
interrupt = 1;
#10
//Reset
clk = 0;
reset=1;
clk_div=3;
spi_miso0=1'bz;
spi_miso1=1'bz;
readback_en=0;
tx_data='h01020304;
spi_read_fifo_full=0;

//disable reset
#10
reset=0;
#30
//data_in_fifo_empty=0;
#10
wait((spi_csb==0))
spi_miso0=1'b1;
spi_miso1=1'b0;
#300
interrupt = 0;
#1000
spi_miso1=1'b1;
spi_miso0=1'b0;
#2000
spi_miso0=1'bZ;
end

always #2 clk = ~clk;


endmodule
