kit-adl/astropix/(commit log)

2020-10-16 Revert "Initial Commit"
    This reverts commit 8b2bdda9091a5f855757eecee505cb18b3ecec8b.
    [AstroPix.PcbLib, AstroPix.SchLib, Astropix_Carrier.PrjPcb, Astropix_Carrier.SchDoc, CircuitWorks-JUMPER.SLDPRT, PCI_ASTROPIX_carrier.PcbDoc, PCI_ASTROPIX_carrier.SchDoc, PCI_HIT_carrier.PcbDoc]
2020-10-18 Astropix Lib update
    [AstroPix.PcbLib, AstroPix.SchLib, Astropix_Carrier.PrjPcb, PCI_ASTROPIX_carrier.PcbDoc, PCI_ASTROPIX_carrier.SchDoc]
2020-10-18 Revert "Astropix Lib update"
    This reverts commit 4b748034e6318753e34dd6f0b782b1aa18e83a46.
    [AstroPix.PcbLib, AstroPix.SchLib, Astropix_Carrier.PrjPcb, PCI_ASTROPIX_carrier.PcbDoc, PCI_ASTROPIX_carrier.SchDoc]
2020-10-19 Added SN65LVDS4 lib
    [SN65LVDS4.PcbLib, SN65LVDS4.SchLib]
2020-10-19 Added correct I/O type to symbol
    [AstroPix.SchLib]
2020-10-21 finalized astropix footprint and Schematic
    [AstroPix.PcbLib, AstroPix.SchLib]
2020-10-21 Added Modified sympol with Gecco pinout
    [PCI_custom_98.SchLib]
2020-10-21 Updated schematic and pcb with new symbols/footprints
    [Astropix_Carrier.PrjPcb, PCI_ASTROPIX_carrier.PcbDoc, PCI_ASTROPIX_carrier.SchDoc]
2020-10-21 Made nicer PCI connector symbol
    [PCI_ASTROPIX_carrier.PcbDoc, PCI_ASTROPIX_carrier.SchDoc]
2020-10-21 Updated PCI connector symbol
    [PCI_custom_98.SchLib]
2020-10-21 Layout update
    [PCI_ASTROPIX_carrier.PcbDoc]
2020-10-21 Move Altium Project to PCB Folder
    [AstroPix.PcbLib, AstroPix.SchLib, Astropix_Carrier.PrjPcb, Astropix_Carrier.SchDoc, CircuitWorks-JUMPER.SLDPRT, PCI_ASTROPIX_carrier.PcbDoc, PCI_ASTROPIX_carrier.SchDoc, PCI_custom_98.SchLib]
2020-10-21 remove old files
    [Astropix_Carrier.SchDoc]
2020-10-21 add netclasses diff, Analog, HV and Power
    [PCI_ASTROPIX_carrier.PcbDoc, PCI_ASTROPIX_carrier.SchDoc]
2020-10-27 Add generic sot23-5 opamp lib
    [Opamp.SchLib, SOT23-5.PcbLib]
2020-10-27 Updated chip lib
    [AstroPix.PcbLib, AstroPix.SchLib]
2020-10-27 Updated Layout and Schematic
    [Astropix_Carrier.PrjPcb, PCI_ASTROPIX_carrier.PcbDoc, PCI_ASTROPIX_carrier.SchDoc]
2020-10-27 Added final chip footprint
    [AstroPix.PcbLib, AstroPix.SchLib]
2020-10-27 Layout update, small Schematic fixes
    [Astropix_Carrier.PrjPcb, PCI_ASTROPIX_carrier.PcbDoc, PCI_ASTROPIX_carrier.SchDoc]
2020-10-27 Added mounting holes for chip cover
    [PCI_ASTROPIX_carrier.PcbDoc]
2020-10-27 Added LVDS Rterm
    [PCI_ASTROPIX_carrier.PcbDoc, PCI_ASTROPIX_carrier.SchDoc]
2020-10-29 Add AD8024 to lib
    [Opamp.PcbLib, Opamp.SchLib, SOT23-5.PcbLib]
2020-10-29 Resize PCB
    [PCI_ASTROPIX_carrier.PcbDoc]
2020-10-29 Placed Ad8024, moved sma conns to Top, added pin headers to every Amp input
    [Astropix_Carrier.PrjPcb, PCI_ASTROPIX_carrier.PcbDoc, PCI_ASTROPIX_carrier.SchDoc]
2020-10-29 Small cosmetic Fixes
    [PCI_ASTROPIX_carrier.PcbDoc]
2020-10-30 Change Opamp LMP7715 -> OPA320
    [Opamp.SchLib]
2020-10-30 Added Bondplan Footprint, fixed left side pads Y Position
    [AstroPix.PcbLib]
2020-10-30 connected AD8024 Disable to FMC, small layout improvements
    [PCI_ASTROPIX_carrier.PcbDoc, PCI_ASTROPIX_carrier.SchDoc]
2020-10-30 Updated Projectfile
    [Astropix_Carrier.PrjPcb]
2020-10-30 Updated Astropix chip lib with bondplan footprint
    [AstroPix.SchLib]
2020-10-30 Updated Parts from library
    [PCI_ASTROPIX_carrier.SchDoc]
2020-10-30 Added Bondplan PCB
    [PCI_ASTROPIX_carrier_Bondplan.PcbDoc]
2020-10-30 Removed Bondplan PCB from Project
    [Astropix_Carrier.PrjPcb]
2020-11-02 Removed Bondwires to unconnected Pads
    [PCI_ASTROPIX_carrier_Bondplan2.PcbDoc]
2020-11-02 Add Variant with unplaced components and Bom
    [Astropix_Carrier_BOM.csv]
2020-11-02 BOM Update
    [Astropix_Carrier_BOM.csv]
2020-11-02 Added Variant
    [PCI_ASTROPIX_carrier.PcbDoc]
2020-11-02 Changed diff Impedance of Sample_CLK to 100 Ohm
    [PCI_ASTROPIX_carrier.PcbDoc]
2020-11-04 Rearrange Ad8024 Input Components(TODO: Cutout internal planes to reduce stray capacitance)
    [PCI_ASTROPIX_carrier.PcbDoc]
2020-11-05 Added coutouts under AD8024 Inputs
    [PCI_ASTROPIX_carrier.PcbDoc]
2020-11-05 Improved OPA320 Layout
    [PCI_ASTROPIX_carrier.PcbDoc]
2020-11-06 wider hv bondpad
    [PCI_ASTROPIX_carrier.PcbDoc]
2020-11-06 Updated VB and Injection to Slots 4/5 , fixed display to DAC tabs
    [mainwindow.cpp]
2020-11-06 Removed Silkscreen frame around Chip
    [PCI_ASTROPIX_carrier.PcbDoc]
2020-11-18 Sch: Changed Capacitances to appropriate values
    [PCI_ASTROPIX_carrier.SchDoc]
2021-01-20 Added Astropix Digital Configbits, IDACs and Voltageboard DACS
2021-01-21 Fix: Asic Config ends in infinite loop, if RamDACs can't be written
    [mainwindow.cpp]
2021-01-21 Correct Pin Order for Chip SR write
    [NexysVideo_Master.xdc]
2021-01-22 Softxare: Checkboxes were not updating the internal values correctly
    [mainwindow.cpp]
2021-01-24 Firmware: Chip Config Debug output on PMOD connector JB Pins 1-4
2021-01-27 Firmware: Fix the mix-up between OUT:res_n and IN:interrupt
    Fix the mix-up between OUT:res_n and IN:interrupt, which holds chipconfig in reset state
    [NexysVideo_Master.xdc]
2021-01-29 SW: API /asic/config/@send "clicks" on Update asic button. If not Nexys is connected the SR bit write runs and prints debugging, but nothing is written to device
2021-01-31 Fixing issue #2 , unused Config elements insert a null widget reference in the model
    [main.cpp, mainwindow.cpp]
2021-02-03 Software: Add Load DACs for Voltage and Injectionboards
    This should fix the problem of writing configs to the wrong boards.
    [mainwindow.cpp]
2021-02-04 PCB: Rev1.1
    - Connect outer Guardrings from Pads and Digital to HV by Bonding 42 to HV Pad
    - Remove powerrail short
    - Move Inj Pin from C5_4 to C5_1
    - Changed external Pullup Resistors to 100k
    - Removed VSSA
    [Astropix_Carrier.PrjPcb, PCI_ASTROPIX_carrier.PcbDoc, PCI_ASTROPIX_carrier.SchDoc]
2021-02-06 Software: Configure 2nd unused output on Injection Board
2021-02-08 PCB: Small cleanup for Rev1.1
    [PCI_ASTROPIX_carrier.PcbDoc]
2021-02-15 PCB: Updated Bondplan
    [PCI_ASTROPIX_carrier_Bondplan2.PcbDoc]
2021-02-23 Added STL for 3D Printed lid
    [Deckel.stl]
2021-02-25 Firmware: Debug: Control res_n with center button
2021-02-25 Firmware: Fix uncomment config_res_n debug output in constraintfile
    [NexysVideo_Master.xdc]
2021-02-25 Firmware: Set Diff sample_clk constant 1 and remove unused 10 Mhz cmd clock
2021-02-25 Firmware: MMCM 220MHz differential sample_clk
2021-02-25 Firmware: Revert Single-ended Chip Config
    [main_top.v]
2021-02-25 Firmware: Revert Single-ended Chip Config 2
    Uncomment differential outputs
    [main_top.v]
2021-03-03 PCB: Updated Bondplan PDF
2021-03-25 Software: Add Injection to API
    Start/Update: http://127.0.0.1:8090/asic/injection/start/0.5/300/100/300
    Params: start/<voltage>/<delay>/<period>/<clkdiv>
    Stop: http://127.0.0.1:8090/asic/injection/stop
2021-03-31 FW: Status LEDs
    LED1: res_n
    LED2: SPI_CS
    LED3: spi_write_fifo_empty
2021-03-31 FW: SPI Module update
2021-04-06 Update README.md
    IVI Compliance Package needed for lasercontrol module (to be removed in a future release)
2021-05-16 SW: Don't create label for Load signals in voltageboard window
2021-05-25 PCB: Delete old Bondplan
2021-06-18 Updating folder structure for Astropix2
    [AstroPix.PcbLib, AstroPix.SchLib, Astropix_Carrier.PrjPcb, Astropix_Carrier_BOM.csv, CircuitWorks-JUMPER.SLDPRT, Opamp.PcbLib, Opamp.SchLib, PCI_ASTROPIX_carrier.PcbDoc]
2021-06-18 Update .gitignore for KiCad project
2021-06-18 Initial commit of Astropix2 KiCad project
    [astropix_v2.kicad_pcb, astropix_v2.sch]
2021-06-23 PCB: Updated Astropix2 schematic
    [astropix_v2.sch]
2021-06-23 Updated 3D Folder for AstroPix2
    [Deckel.stl]
2021-06-24 SW: Removed Lasercontrol and VISA
    -Removed unused functions
    -Restored fastreadout lib files
2021-07-07 Updated Schematic and Asic footprint
    [astropix_v2.sch]
2021-07-08 PCB: First astropix2 layout
    [astropix_v2.kicad_pcb, astropix_v2.sch]
2021-07-09 PCB: Updated Footprints
2021-07-09 PCB: Updated astropix2 pcb
    -diff pair impedance
    -added teardropds
    -small fixes
    [astropix_v2.csv, astropix_v2.kicad_pcb, astropix_v2.sch]
2021-07-09 PCB: Cosmetic Fixes
    [astropix_v2.kicad_pcb]
2021-07-12 PCB: Small corrections
    [astropix_v2-B_Cu.gbr, astropix_v2-B_Mask.gbr, astropix_v2-B_Paste.gbr, astropix_v2-B_SilkS.gbr, astropix_v2-Edge_Cuts.gbr, astropix_v2-F_Cu.gbr, astropix_v2-F_Mask.gbr, astropix_v2-F_Paste.gbr]
2021-07-22 PCB: Apix v2 updates
    - Added SPI series resistors
    - connected spi_right_clk to FMC
    - Updated Amplifier Layout
    [astropix_v2-B_Adhes.gbr, astropix_v2-B_CrtYd.gbr, astropix_v2-B_Cu.gbr, astropix_v2-B_Fab.gbr, astropix_v2-B_Mask.gbr, astropix_v2-B_SilkS.gbr, astropix_v2-Cmts_User.gbr, astropix_v2-Dwgs_User.gbr]
2021-07-24 FW: Simple fix for CDC timing fail
    - Use same clock for patgen and ftdi, 100 MHz is sufficient for Astropix Hitrates
    [main_top.v]
2021-07-24 FW: Added Reset value for spi_read_fifo
    - Undefined spi_read_fifo_rdcount caused SPI read_data <= 8'hff;
    [RegisterFile.v]
2021-07-24 FW: Fixed spi_read_fifo enable always low
    - Wrong address 23 in spi_read_fifo enable assertion, caused enable to stay always low
    [RegisterFile.v]
2021-07-25 FW: Update v1 SPI Readout
    - Fixed spi module (see also de94172 and 1d7eae7)
    - Changed MISO pin type
    - Fixed writeFIFO wire width
    - Added some comments
    [ftdi_top.v, main_top.v, spi_readout.v]
2021-07-26 FW: SPI Module for Astropix2 miso0, miso1
    - Updated SPI Module
    - Added rudimentary tb
2021-07-27 FW: Cleanup v2
    - Removed unused ip
    - fixed mmcm output names
    [RegisterFile.v, clk_wiz_0_clk_wiz.v, clk_wiz_0_sim_netlist.v, clk_wiz_0_sim_netlist.vhdl, clk_wiz_0_stub.v, clk_wiz_0_stub.vhdl]
2021-07-27 PCB: Added holes for HIT bonding fixture
    [astropix_v2.kicad_pcb, astropix_v2.sch]
2021-07-30 PCB: Added Astropix2 Bondplan and missing bonding fixture module
2021-08-04 PCB V2: Connected SR_out/RB + Updated production files
    [astropix_v2-B_Adhes.gbr, astropix_v2-B_CrtYd.gbr, astropix_v2-B_Cu.gbr, astropix_v2-B_Fab.gbr, astropix_v2-B_Mask.gbr, astropix_v2-B_Paste.gbr, astropix_v2-B_SilkS.gbr, astropix_v2-Cmts_User.gbr]
2021-08-04 PCB V2: Updated pdf schematic
2021-08-04 PCB V2: Updated Teardrops
    [astropix_v2-B_Adhes.gbr, astropix_v2-B_CrtYd.gbr, astropix_v2-B_Cu.gbr, astropix_v2-B_Fab.gbr, astropix_v2-B_Mask.gbr, astropix_v2-B_Paste.gbr, astropix_v2-B_SilkS.gbr, astropix_v2-Cmts_User.gbr]
2021-08-12 PCB v2: Added markings for Bonding
    -Updated gerber and assembly files
    [astropix_v2-B_Adhes.gbr, astropix_v2-B_CrtYd.gbr, astropix_v2-B_Cu.gbr, astropix_v2-B_Fab.gbr, astropix_v2-B_Mask.gbr, astropix_v2-B_Paste.gbr, astropix_v2-B_SilkS.gbr, astropix_v2-Cmts_User.gbr]
2021-08-16 PCB v1: Added Gerber Files
2021-08-16 PCB v1: Fixed floating SR_RB and updated gerbers
    [PCI_ASTROPIX_carrier.PcbDoc, PCI_ASTROPIX_carrier.SchDoc]
2021-11-15 3D: Astropix2 chip cover
    [astropix_v2.stl]
2021-11-17 3D: Astropix2 thicker walls
    [astropix_v2.stl]
2022-01-04 Top, SPI, Constraints: see details below
    - Top: Added Timestampclk_div2, fixed port directions
    - updated constraints
    - SPI: added continous write until WriteFifo is empty
    - SPI: write/read leading/trailing edge
    [NexysVideo_Master.xdc, clk_wiz_0.v, clk_wiz_0_clk_wiz.v, clk_wiz_0_sim_netlist.v, clk_wiz_0_sim_netlist.vhdl, clk_wiz_0_stub.v, clk_wiz_0_stub.vhdl, main_top.v]
2022-01-25 FW2: Fixed bug which prevented chip configuration with standard GECCO board
    [NexysVideo_Master.xdc, main_top.v]
2022-03-13 FW2: SR readback added missing resetvalue
    [RegisterFile.v]
2022-12-21 PCB: AstroPix3 carrier WIP
    [astropix_v3.kicad_pcb, astropix_v3.kicad_sch]
2022-12-22 PCB: Astropix3 updates
    [astropix_v3.kicad_pcb, astropix_v3.kicad_sch]
2023-01-09 PCB: Astropix3 update
    [astropix_v3.kicad_pcb, astropix_v3.kicad_sch]
2023-01-13 PCB: Added AstroPix3 quadchip schematic
2023-02-01 PCB: Added final V3 PCB with fabrication data
    [astropix_v3-B_Adhesive.gbr, astropix_v3-B_Courtyard.gbr, astropix_v3-B_Cu.gbr, astropix_v3-B_Fab.gbr, astropix_v3-B_Mask.gbr, astropix_v3-B_Paste.gbr, astropix_v3-B_Silkscreen.gbr, astropix_v3-Edge_Cuts.gbr]
2023-02-01 PCB: Connected HV Pad
    [astropix_v3-B_Adhesive.gbr, astropix_v3-B_Courtyard.gbr, astropix_v3-B_Cu.gbr, astropix_v3-B_Fab.gbr, astropix_v3-B_Mask.gbr, astropix_v3-B_Paste.gbr, astropix_v3-B_Silkscreen.gbr, astropix_v3-Edge_Cuts.gbr]
2023-02-06 FW: Updated SPI readout on interrupt
2023-02-10 PCB: V3 improvements
    [astropix_v3-B_Adhesive.gbr, astropix_v3-B_Courtyard.gbr, astropix_v3-B_Cu.gbr, astropix_v3-B_Fab.gbr, astropix_v3-B_Mask.gbr, astropix_v3-B_Paste.gbr, astropix_v3-B_Silkscreen.gbr, astropix_v3-Edge_Cuts.gbr]
2023-05-24 FW: Telescope V2 fixed fast clock pins
    [NexysVideo_Master.xdc, async_fifo_ftdi.vhd, async_fifo_ftdi_stub.v, async_fifo_ftdi_stub.vhdl, clk_wiz_0_sim_netlist.v, clk_wiz_0_sim_netlist.vhdl]
2023-07-12 FW V2: Automatic SPI readout on interrupt
2023-07-20 FW V3: Implemented SPI updates from V2
2023-08-18 FW2: Fixed constraints for diff chip config
    [NexysVideo_Master.xdc]
2023-09-14 Fw: TCL constraints, spi readout updates
2023-09-14 FW: Revert changes in NexysVideo_Master.xdc
    [NexysVideo_Master.xdc]
2023-09-28 PCB: WIP AstroPix4
    [astropix_v3-B_Adhesive.gbr, astropix_v3-B_Courtyard.gbr, astropix_v3-B_Cu.gbr, astropix_v3-B_Fab.gbr, astropix_v3-B_Mask.gbr, astropix_v3-B_Paste.gbr, astropix_v3-B_Silkscreen.gbr, astropix_v3-Edge_Cuts.gbr]
2023-09-29 PCB: AstroPix4 v1 \w production files + bondplan
    [astropix_v3-B_Adhesive.gbr, astropix_v3-B_Courtyard.gbr, astropix_v3-B_Cu.gbr, astropix_v3-B_Fab.gbr, astropix_v3-B_Mask.gbr, astropix_v3-B_Paste.gbr, astropix_v3-B_Silkscreen.gbr, astropix_v3-F_Adhesive.gbr]
2023-09-29 PCB: V4 added schematic
2026-02-06 Updated KiCAD .gitignore, removed old backup files
